WenJunYu5984/CG2111-project-group2B-24-25/README.md

# CG2111-project-group2B-24-25

#This is a project where our robot has to navigate a maze and deliver a medpak and drag an astronaut while we are unable to see the environment the robot is in. Members of this project are Cai Jia Li, Malcolm, Wesley Low and Wen Jun Yu
