WenJunYu5984/CG2111-project-group2B-24-25/Alex/Alex.ino

#include <serialize.h>

#include "packet.h"
#include "constants.h"
#include <stdarg.h>


/*
 * Alex's configuration constants
 */
volatile TDirection dir;

// Number of ticks per revolution from the 
// wheel encoder.

#define COUNTS_PER_REV      4

// Wheel circumference in cm.
// We will use this to calculate forward/backward distance traveled 
// by taking revs * WHEEL_CIRC

#define WHEEL_CIRC          21

#define ALEX_LENGTH 25.5
#define ALEX_BREADTH 15.8

#define ULTRASONIC_TRIG (1 << 1)
#define ULTRASONIC_ECHO (1 << PD0)

float alexDiagonal = 29.998;
float alexCirc = 94.242;

bool ultraSensing = false;
volatile long sonicDist = 0;

// Store the ticks from Alex's left and
// right encoders.
volatile unsigned long leftForwardTicks; 
volatile unsigned long rightForwardTicks;
volatile unsigned long leftReverseTicks; 
volatile unsigned long rightReverseTicks;

//Left and Right encoder Ticks for turning
volatile unsigned long leftForwardTicksTurns; 
volatile unsigned long rightForwardTicksTurns;
volatile unsigned long leftReverseTicksTurns; 
volatile unsigned long rightReverseTicksTurns;

// Store the revolutions on Alex's left
// and right wheels
volatile unsigned long leftRevs;
volatile unsigned long rightRevs;

// Forward and backward distance traveled
volatile unsigned long forwardDist;
volatile unsigned long reverseDist;
unsigned long deltaDist;
unsigned long newDist;

unsigned long deltaTicks;
unsigned long targetTicks;

//Moving Alex
unsigned long computeDeltaTicks(float ang) {
  unsigned long ticks = (unsigned long) ((ang * alexCirc * COUNTS_PER_REV) / (360.0 * WHEEL_CIRC));
  return ticks;
}

void left(float ang, float speed) {
  if (ang == 0) {
    deltaTicks = 999999999;
  } else {
    deltaTicks = computeDeltaTicks(ang);
  }
  targetTicks = leftReverseTicksTurns + deltaTicks;
  
  ccw(ang,speed);
}

void right(float ang, float speed) {
  if (ang == 0) {
    deltaTicks = 999999999;
  } else {
    deltaTicks = computeDeltaTicks(ang);
  }
  targetTicks = rightReverseTicksTurns + deltaTicks;
  
  cw(ang,100);
}

/*
 * 
 * Alex Communication Routines.
 * 
 */
 
TResult readPacket(TPacket *packet)
{
    // Reads in data from the serial port and
    // deserializes it.Returns deserialized
    // data in "packet".
    
    char buffer[PACKET_SIZE];
    int len;

    len = readSerial(buffer);

    if(len == 0)
      return PACKET_INCOMPLETE;
    else
      return deserialize(buffer, len, packet);
    
}

void sendStatus()
{
  // Implement code to send back a packet containing key
  // information like leftTicks, rightTicks, leftRevs, rightRevs
  // forwardDist and reverseDist
  // Use the params array to store this information, and set the
  // packetType and command files accordingly, then use sendResponse
  // to send out the packet. See sendMessage on how to use sendResponse.
  TPacket statusPacket;
  statusPacket.packetType = PACKET_TYPE_RESPONSE;
  statusPacket.command = RESP_STATUS;
  statusPacket.params[0] = leftForwardTicks;
  statusPacket.params[1] = rightForwardTicks;
  statusPacket.params[2] = leftReverseTicks;
  statusPacket.params[3] = rightReverseTicks;
  statusPacket.params[4] = leftForwardTicksTurns;
  statusPacket.params[5] = rightForwardTicksTurns;
  statusPacket.params[6] = leftReverseTicksTurns;
  statusPacket.params[7] = rightReverseTicksTurns;
  statusPacket.params[8] = forwardDist;
  statusPacket.params[9] = reverseDist;

  sendResponse(&statusPacket);
}

void sendMessage(const char *message)
{
  // Sends text messages back to the Pi. Useful
  // for debugging.
  
  TPacket messagePacket;
  messagePacket.packetType=PACKET_TYPE_MESSAGE;
  strncpy(messagePacket.data, message, MAX_STR_LEN);
  sendResponse(&messagePacket);
}

void dbprintf(const char* format, ...) {
  va_list args;
  char buffer[128];
  va_start(args,format);
  vsprintf(buffer,format,args);
  sendMessage(buffer);
}

void sendBadPacket()
{
  // Tell the Pi that it sent us a packet with a bad
  // magic number.
  
  TPacket badPacket;
  badPacket.packetType = PACKET_TYPE_ERROR;
  badPacket.command = RESP_BAD_PACKET;
  sendResponse(&badPacket);
  
}

void sendBadChecksum()
{
  // Tell the Pi that it sent us a packet with a bad
  // checksum.
  
  TPacket badChecksum;
  badChecksum.packetType = PACKET_TYPE_ERROR;
  badChecksum.command = RESP_BAD_CHECKSUM;
  sendResponse(&badChecksum);  
}

void sendBadCommand()
{
  // Tell the Pi that we don't understand its
  // command sent to us.
  
  TPacket badCommand;
  badCommand.packetType=PACKET_TYPE_ERROR;
  badCommand.command=RESP_BAD_COMMAND;
  sendResponse(&badCommand);
}

void sendBadResponse()
{
  TPacket badResponse;
  badResponse.packetType = PACKET_TYPE_ERROR;
  badResponse.command = RESP_BAD_RESPONSE;
  sendResponse(&badResponse);
}

void sendOK()
{
  TPacket okPacket;
  okPacket.packetType = PACKET_TYPE_RESPONSE;
  okPacket.command = RESP_OK;
  sendResponse(&okPacket);  
}

void sendResponse(TPacket *packet)
{
  // Takes a packet, serializes it then sends it out
  // over the serial port.
  char buffer[PACKET_SIZE];
  int len;

  len = serialize(buffer, packet, sizeof(TPacket));
  writeSerial(buffer, len);
}


/*
 * Setup and start codes for external interrupts and 
 * pullup resistors.
 * 
 */
// Enable pull up resistors on pins 18 and 19
void enablePullups()
{
  // Use bare-metal to enable the pull-up resistors on pins
  // 19 and 18. These are pins PD2 and PD3 respectively.
  // We set bits 2 and 3 in DDRD to 0 to make them inputs. 
  DDRD &= ~(0b00001100); //sets pin 18 and 19 to input mode
  PORTD |= 0b00001100; //write 1 to pins 18 and 19 to enable pullup
}

// Functions to be called by INT2 and INT3 ISRs.
void leftISR()
{ 
  // when leftISR is called, we check dir called, if dir is forwards or backwards,leftForwardTicks and leftReverseTicks will be updated correspondingly,
  //if Left or right the leftReverseTicksTurns and leftForwardTicksTurns will be updated correspondling
  if (dir == FORWARD) {
    leftForwardTicks++;
    // only in the leftISR, we will update forwardDist and reverseDist respectively
    forwardDist = (unsigned long) ((float) leftForwardTicks / COUNTS_PER_REV * WHEEL_CIRC);
  }
  else if (dir == BACKWARD) {
    leftReverseTicks++;
    reverseDist = (unsigned long) ((float) leftReverseTicks / COUNTS_PER_REV * WHEEL_CIRC);
  } else if (dir == LEFT) {
    leftReverseTicksTurns++;
  } else if (dir == RIGHT) {
    leftForwardTicksTurns++;
  }

}

void rightISR()
{
   // when leftISR is called, we check dir called, if dir is forwards or backwards,rightForwardTicks and rightReverseTicks will be updated correspondingly, 
  //if Left or right the rightReverseTicksTurns and rightForwardTicksTurns will be updated correspondling
  if (dir == FORWARD) {
    rightForwardTicks++;
  }
  else if (dir == BACKWARD) {
    rightReverseTicks++;
  } else if (dir == RIGHT) {
    rightReverseTicksTurns++;
  } else if (dir == LEFT) {
    rightForwardTicksTurns++;
  }
  
}

// Set up the external interrupt pins INT2 and INT3
// for falling edge triggered. Use bare-metal.
void setupEINT()
{
  // Use bare-metal to configure pins 18 and 19 to be
  // falling edge triggered. Remember to enable
  // the INT2 and INT3 interrupts.
  // Hint: Check pages 110 and 111 in the ATmega2560 Datasheet.
  EIMSK |= 0b00001100;
  EICRA |= 0b10100000;
}

// Implement the external interrupt ISRs below.
// INT3 ISR should call leftISR while INT2 ISR
// should call rightISR.


// Implement INT2 and INT3 ISRs above.
ISR(INT2_vect) {
  rightISR();
}

ISR(INT3_vect) {
  leftISR();
}

/*
 * Setup and start codes for serial communications
 * 
 * Alex's setup and run codes
 * 
 */

void setBaud(unsigned long baudRate) {
  unsigned int b;
  b = (unsigned int) round(F_CPU / (16.0 * baudRate)) -1;
  UBRR0H = (unsigned char) (b >> 8);
  UBRR0L = (unsigned char) b;
}

void setupSerial()
{
  PRR0 &= ~(1 << PRUSART0); // make sure UART power is on 
  setBaud(9600); // set baud rate  
  UCSR0C = 0b00000110; // using Async UART, 8N1
  UCSR0A = 0; // clear while setting up
  // thsese replace Serial.begin(9600)
}

// Start the serial connection. For now we are using
// Arduino wiring and this function is empty.

void startSerial()
{
  UCSR0B = 0b00011000; // enable RX and TX (disable bits 6 and 7 - TX and RX interrupts)
}

// Read the serial port. Returns the read character in
// ch if available. Also returns TRUE if ch is valid. 

int readSerial(char *buffer)
{
  int count=0;
  // poll RXC0 bit in UCSR0A
  while((UCSR0A & (1 << RXC0))) {
    // read data from buffer 
    buffer[count++] = UDR0;
  }
  return count;
}

// Write to the serial port

void writeSerial(const char *buffer, int len)
{
  for (int i = 0; i < len; i++) {
    // poll UDRE bit in UCSR0 - if 1 means UDR0 is empty - can write to it 
    while (!(UCSR0A & (1 << UDRE0)));
    UDR0 = buffer[i]; // write each byte of the buffer
  }
}

// Clears all our counters
void clearCounters()
{
  leftForwardTicks=0;
  rightForwardTicks=0;
  leftReverseTicks=0;
  rightReverseTicks=0;
  leftForwardTicksTurns=0;
  rightForwardTicksTurns=0;
  leftReverseTicksTurns=0;
  rightReverseTicksTurns=0;
  leftRevs=0;
  rightRevs=0;
  forwardDist=0;
  reverseDist=0; 
}

// Intialize Alex's internal states

void initializeState()
{
  clearCounters();
}


void ultrasonic() {
  DDRC |= ULTRASONIC_TRIG;
  delayMicroseconds(10);
  DDRC &= ~ULTRASONIC_TRIG;
  //for (int i = 0; i < 100; i++) dbprintf("pin 37 %d", PINC & ULTRASONIC_ECHO);
  long duration = pulseIn(21, HIGH);
  int dist = duration * 0.034 / 2;
  if (dist == 0) dist = 1000;
    dbprintf("Approaching wall: %d", dist);
  
}

void handleCommand(TPacket *command)
{
  switch(command->command)
  {
    // For movement commands, param[0] = distance, param[1] = speed.
    case COMMAND_FORWARD:
        sendOK();
        forward((double) command->params[0], (float) command->params[1]);
        //move_forward(); 
        break;

    case COMMAND_REVERSE:
        sendOK();
        backward((double) command->params[0], (float) command->params[1]);
        break;
        
    case COMMAND_TURN_LEFT:
        sendOK();
        left((double) command->params[0], (float) command->params[1]);
        break;
        
    case COMMAND_TURN_RIGHT:
        sendOK();
        right((double) command->params[0], (float) command->params[1]);
        break;

    case COMMAND_OPEN:
        sendOK();
        openservo();
        break;

    case COMMAND_CLOSE:
        sendOK();
        closeservo();
        break;

    case COMMAND_COLOUR:
        sendOK();
        readColour();
        break;

    case COMMAND_DELIVER:
        sendOK();
        dispense();
        break;
    case COMMAND_SONIC:
        sendOK();
        ultrasonic();
    case COMMAND_STOP:
        sendOK();
        stop();
      break;

    case COMMAND_GET_STATS:
        sendStatus();
        sendOK();
        break;

    case COMMAND_CLEAR_STATS:
        sendOK();
        clearCounters();
        break;
        
    default:
      sendBadCommand();
  }
}

void waitForHello()
{
  int exit=0;

  while(!exit)
  {
    TPacket hello;
    TResult result;
    
    do
    {
      result = readPacket(&hello);
    } while (result == PACKET_INCOMPLETE);

    if(result == PACKET_OK)
    {
      if(hello.packetType == PACKET_TYPE_HELLO)
      {
     

        sendOK();
        exit=1;
      }
      else
        sendBadResponse();
    }
    else
      if(result == PACKET_BAD)
      {
        sendBadPacket();
      }
      else
        if(result == PACKET_CHECKSUM_BAD)
          sendBadChecksum();
  } // !exit
}


void setupUltrasonic() {
  
  DDRC |= ULTRASONIC_TRIG; // Set trig pin to output
  DDRH &= ~ULTRASONIC_ECHO; // Set echo pin to input
  PORTC &= ~ULTRASONIC_TRIG; // Clear trig pin
  
}


void setup() {
  // put your setup code here, to run once:

  cli();
  setupEINT();
  setupSerial();
  startSerial();
  enablePullups();
  initializeState();
  initializeColourSensor();
  setupservo();
  setupUltrasonic();
  //setupMotor();
  sei();
}

void handlePacket(TPacket *packet)
{
  switch(packet->packetType)
  {
    case PACKET_TYPE_COMMAND:
      handleCommand(packet);
      break;

    case PACKET_TYPE_RESPONSE:
      break;

    case PACKET_TYPE_ERROR:
      break;

    case PACKET_TYPE_MESSAGE:
      break;

    case PACKET_TYPE_HELLO:
      break;
  }
}

void loop() {

 // put your main code here, to run repeatedly:
  TPacket recvPacket; // This holds commands from the Pi

  TResult result = readPacket(&recvPacket);
  
  if(result == PACKET_OK)
    handlePacket(&recvPacket);
  else
    if(result == PACKET_BAD)
    {
      sendBadPacket();
    }
    else
      if(result == PACKET_CHECKSUM_BAD)
      {
        sendBadChecksum();
      }
      
   if(deltaDist >0) {
     if (dir == FORWARD) {
      if (forwardDist > newDist) {
        deltaDist = 0;
        newDist = 0;
        stop();
      }
     }
   
     if (dir == BACKWARD) {
      if (reverseDist > newDist) {
        deltaDist = 0;
        newDist = 0;
        stop();
      }
    }
   } 

   if (deltaTicks > 0) {
    //dbprintf("delta %i   target %i", deltaTicks, targetTicks);
    if (dir == LEFT) {
      if (leftReverseTicksTurns >= targetTicks) {
        deltaTicks = 0;
        targetTicks = 0;
        stop();
      }
    } else if (dir == RIGHT) {
      if (leftForwardTicksTurns >= targetTicks) {
        deltaTicks = 0;
        targetTicks = 0; 
        stop();
      }
    } 
   }
      
}
