WenJunYu5984/CG2111-project-group2B-24-25/Alex/robotlib.ino

#include <AFMotor.h>
// Direction values


// Motor control
#define FRONT_LEFT   4 // M4 on the driver shield
#define FRONT_RIGHT  3 // M1 on the driver shield
#define BACK_LEFT    1 // M3 on the driver shield
#define BACK_RIGHT   2 // M2 on the driver shield

AF_DCMotor motorFL(FRONT_LEFT);
AF_DCMotor motorFR(FRONT_RIGHT);
AF_DCMotor motorBL(BACK_LEFT);
AF_DCMotor motorBR(BACK_RIGHT);

void move(float speed, int direction)
{
  int speed_scaled = (speed/100.0) * 255;
  motorFL.setSpeed(speed_scaled);
  motorFR.setSpeed(speed_scaled);
  motorBL.setSpeed(speed_scaled);
  motorBR.setSpeed(speed_scaled);

  switch(direction)
    {
      case GO:
        motorFL.run(FORWARD);
        motorFR.run(BACKWARD);
        motorBL.run(FORWARD);
        motorBR.run(BACKWARD); 
      break;
      case BACK:
        motorFL.run(BACKWARD);
        motorFR.run(FORWARD);
        motorBL.run(BACKWARD);
        motorBR.run(FORWARD); 
      break;
      case CW:
        motorFL.run(FORWARD);
        motorFR.run(FORWARD);
        motorBL.run(FORWARD);
        motorBR.run(FORWARD); 
      break;
      case CCW:
        motorFL.run(BACKWARD);
        motorFR.run(BACKWARD);
        motorBL.run(BACKWARD);
        motorBR.run(BACKWARD); 
      break; 

      case DEPLOY:
        motorFL.run(FORWARD);
        motorBL.run(BACKWARD);
      break;

      case STOP:
      default:
        motorFL.run(STOP);
        motorFR.run(STOP);
        motorBL.run(STOP);
        motorBR.run(STOP);
      
    }
}

void forward(float dist, float speed)
{
  if (dist > 0) {
    deltaDist = dist;
  } else {
    deltaDist = 9999999;
  }

  newDist = deltaDist + forwardDist;
  dir = (TDirection) FORWARD;
  move(speed, FORWARD);
}

void backward(float dist, float speed)
{

  if (dist > 0) {
    deltaDist = dist;
  } else {
    deltaDist = 9999999;
  }

  newDist = deltaDist + reverseDist;
  dir = (TDirection) BACKWARD;
  move(speed, BACKWARD);
}

void ccw(float dist, float speed)
{
  dir = (TDirection) LEFT;
  move(speed, CCW);
}

void cw(float dist, float speed)
{
  dir = (TDirection) RIGHT;
  move(speed, CW);
}

void stop()
{
  move(0, STOP);
}
